HiramHerrera/Wave-Function-Generator/README.md

# Wave Function Generator

## This is the final project for the Instrumentation class. 
Authors: Hiram Herrera & Osvaldo Rosales

University: Universidad Autónoma de Baja California

Teacher: Eloísa del Carmen García Canseco

## Folders Description
documentation/ contains the written work(.tex and .pdf) and presentation (.pptx) for this project 

code/ folder contains the source code for the wave function generator written in arduino language (.ino)
